osprey-dcs/rf-input-fmc/datasheet.md

- 2 Independent RF inputs
- 15 Digital inputs
- 1 PPS input

## Clock Inputs

| **parameter** | value |
| --- | --- |
| connector type | SMA-F |
| Targeted Input Bandwidth | 50MHz- 200Mhz |
| Absolute Input Bandwidth | 50MHz- 3000Mhz |
| Input Range | -5 to +20 dBm |
| Absolute Input Range | -5.8dbm - 25.9 dBm |
| Clock Divider | 1x - (1/8)x |
| Input Impedance | 50 ohm +/- 0.5% |

### Input Bandwidth
We are targeting a 50-200MHz input, while the input parts are rated for higher then 200Mhz operation, we will be likely limited by non-ideal effects of the realized circuit.
LMK and front end can handle

| **Part** | **Frequency(MHz)** |
| --- | --- |
| TCP-2-33W+ | 50 - 3000 |
| TCM2-33WX+ | 10 - 3000 |
| LMK01801 | ?- 3100 |
The FPGA Clock input only operate up to 650MHz.
<span style="color: red;">Dividers bringing the final input frequency down to below 650MHz must be used.</span>
Realistically, that layout will limit the bandwidth *we should test this limit*

### Input Range

From LMK01801 [datasheet](https://www.ti.com/lit/ds/symlink/lmk01801.pdf) section 7.4:
Vin_max = 3.1V p-p
Vin_min = 0.5V p-p

Adding in the losses from input transformers we arrive at an input range of:
2.26dBm though 18.11 dBm.

An absolute max input can 19.41 dBm.
## Digital Inputs

| **parameter** | value |
| --- | --- |
| connector type | Samtec Isorate *Part Number* |
| input impedance | 50 ohm(PPS Input) or high impedance |
| V<sub>IH</sub> | > 1.70 V |
| V<sub>IL</sub> | < 0.70 V |
| Intended Input Logic Levels | 5.0V, 3.3V, 2.5V |
| Absolute Maximum Input | 6.5V |
| Maximum Switching Speed | <span style="color: red;">????</span> |

## FMC PINOUT
<span style="color: red;">Add pinout here</span>
** What cannot be tri-stated with other firmware
- sample clk output - Quartz?
-
## Connector
The mating connector is as thin as the right angle part so the right angle connector can sit back on the board.
![[Pasted image 20251030092402.png]]

We will need 28 mm of clarence min above the board for the connector
![[Pasted image 20251030104230.png]]
