osprey-dcs/rf-input-fmc/(commit log)

2025-09-30 Initial Commit
    Basic Schematic Started.
    Needs polish but components are in.
    [digital_inputs.kicad_sch, fmc.kicad_sch, housekeeping.kicad_sch, rf-input-fmc.kicad_pcb, rf-input-fmc.kicad_sch, rf_input.kicad_sch]
2025-10-01 Draft Schematic Complete
    -See design.md for remaining design work/questions
    -See output folder for current schematic prints
    [adc.kicad_sch, digital_inputs.kicad_sch, eeprom.kicad_sch, fmc.kicad_sch, housekeeping.kicad_sch, level_shifter.kicad_sch, rf-input-fmc.kicad_sch, rf_input.kicad_sch]
2025-10-04 lmk01801 symbol pin types and datasheet link
    [rf_input.kicad_sch]
2025-10-04 add power flags
    [fmc.kicad_sch]
2025-10-04 fixup some hierarchical buses
    [digital_inputs.kicad_sch, fmc.kicad_sch, level_shifter.kicad_sch, rf-input-fmc.kicad_sch, rf_input.kicad_sch]
2025-10-04 show inter-sheet references for global labels
    [level_shifter.kicad_sch]
2025-10-06 Schamtic Revision
    - Added 8 more D inputs
    - Removed 1 LMK01801 IC
    - Cleaned up some buses
    [adc.kicad_sch, clk_distribution.kicad_sch, digital_inputs.kicad_sch, eeprom.kicad_sch, fmc.kicad_sch, level_shifter.kicad_sch, rf-input-fmc.kicad_sch, rf_input.kicad_sch]
2025-10-07 Draft Schematic Revision
    Schematic should be in good shape.
    Meta-data and BOM need to be finished.
    Very rough layout was started to floorplan out main parts and to see if we have room.
    [adc.kicad_sch, clk_distribution.kicad_sch, digital_inputs.kicad_sch, eeprom.kicad_sch, fmc.kicad_sch, level_shifter.kicad_sch, rf-input-fmc.kicad_pcb, rf-input-fmc.kicad_sch]
2025-10-14 add copyright/license
    [adc.kicad_sch, clk_distribution.kicad_sch, digital_inputs.kicad_sch, eeprom.kicad_sch, fmc.kicad_sch, level_shifter.kicad_sch, rf-input-fmc.kicad_pcb, rf-input-fmc.kicad_sch]
2025-10-16 Changed ADC and removed Level Shifter
    - Changed ADC to ADS7253
    - Removed Level Shifters
    - Change paper size to US standard sizes for printing
    - removed 3d models
    - Changed SMA clock input to a 2 pin ISORATE connector
    - Floor planned out the PCB layout with the new parts
    [adc.kicad_sch, clk_distribution.kicad_sch, digital_inputs.kicad_sch, eeprom.kicad_sch, fmc.kicad_sch, level_shifter.kicad_sch, rf-input-fmc.kicad_pcb, rf-input-fmc.kicad_sch]
2025-10-28 Final Schmatic Draft
    -Changed ADC
    -Changed Digital IO Translator
    -Updated all MPNs
    - Reannoted Schematic
    - Updated Design Document
    - Added new Datasheet Document
    [adc.kicad_sch, digital_inputs.kicad_sch, eeprom.kicad_sch, fmc.kicad_sch, rf-input-fmc.kicad_pcb, rf-input-fmc.kicad_sch, rf_input.kicad_sch]
2025-10-30 Updated Footprint of Connectors
    -Added a 0 ohm resistor after the 5V LDO
    - fixed some part numbers
    - adding 3d model to the isorate connectors
    - updated datasheet/design docs
    - changed one of the DIO connector to a vertical connector
    [adc.kicad_sch, digital_inputs.kicad_sch, fmc.kicad_sch, rf-input-fmc.kicad_pcb]
2025-11-04 Schematic updates
    - Changed Connecters to MMCX
    - Added Test points on clocks and data buses
    - Added attenuation before the RF input level detection IC to better keep the recommended input within its linear range
    - Added a low pass filter at the input of the RF input level detection IC
    - grounded the thermal pad of the ADC
    - added some additional decoupling caps in for the clock splitter chip (to be in line with what is on Zest)
    [adc.kicad_sch, clk_distribution.kicad_sch, digital_inputs.kicad_sch, eeprom.kicad_sch, rf-input-fmc.kicad_pcb, rf-input-fmc.kicad_sch, rf_input.kicad_sch]
2025-11-04 Fixed Physical Board Demensions
    - mirrored and resized the board outlined to match the FMC standard
    - added two non-electrical mounting holes (created a footprint for these)
    - moved and locked the FMC connector and mounting holes to FMC standard locations.
    - moved connector to fit the new board size
    [fmc.kicad_sch, rf-input-fmc.kicad_pcb]
2025-11-11 Updated BOM of all parts
    Updated BOM of all parts
    -added supplier & supplier part number to all parts
    - fixed many issues with part including:R5-R8,C34,C35,C24, R10-R15
    Changed filter C36&C37 to 15nF (keep COG & 0603, but changes filter cutoff to 3.8kHz|was 12kHz)
    Changed bulk Caps to 22uF (was 47uF) to get a Cap with enough voltage headroom at 12V while 0805
    Changed C31 to be a bulk 10uF cap
    [adc.kicad_sch, clk_distribution.kicad_sch, digital_inputs.kicad_sch, eeprom.kicad_sch, fmc.kicad_sch, rf-input-fmc.kicad_pcb, rf-input-fmc.kicad_sch, rf_input.kicad_sch]
2025-12-02 Finished Board Layout
    Schematic Changes
    - Removed some testpoints
    - Fixed Lib issues
    - moved around FMC pinout
    Layout
    - routed all traces
    - routed RF traces using Controlled Impedance in mind
    - ERC/DRC free
    - All silkscreen is arranged
    Still to do
    - finish net-classes for controlled traces
    - create arc traces for diff CLK lines
    - small tweaks to improve RF performance
    [adc.kicad_sch, digital_inputs.kicad_sch, fmc.kicad_sch, rf-input-fmc.kicad_pcb, rf-input-fmc.kicad_sch, rf_input.kicad_sch]
2025-12-02 Tweaks to Layout/ fixed project errors
    -Adjusted Testpoints by changing the value field to visible on the silkscreen layer.
    - Fixed DRC and ERC issues
    Known to do:
    - run rounded traces
    - determine neg/gnd pin of J20 (do we want to float but diff? SE?)
    - determine/implement best practice grounding for mounting holes?
    - Additional RF trace tweaking
    [adc.kicad_sch, clk_distribution.kicad_sch, digital_inputs.kicad_sch, fmc.kicad_sch, rf-input-fmc.kicad_pcb]
2025-12-05 updated layout to improve RF
    - Improved RF traces
    -Changed some 0603 passives to 0402 parts
    - Changed J1 &J2 to SMA connectors
    [clk_distribution.kicad_sch, rf-input-fmc.csv, rf-input-fmc.kicad_pcb, rf_input.kicad_sch]
2025-12-20 Final Draft for prototype run
    - Updated CLK mapping to FMC
    - Now Output 12 goes to M2C CLK instead of a GBT CLK
    - Outputs 0, 4, 8 have moved
    - all CLK now have polarity swapped at the FMC pin
    - CLK signals maintain normal polarity through the CLK distribution chip but are now ALL swapped between the CLK Distribution IC output and the FMC pins
    - Added a monitor output on Output13 (J20)
    - Moved decoupling caps to bottom of LCB in many places
    - Standardized the area to the right of the FMC to use as a future template
    - Moved board specific test points and function to the left
    - Added an additional bypass cap on U8
    - Tied the front two mounting hole (H3 &H4) to GND
    - changed H2 to be a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
    [clk_distribution.kicad_sch, digital_inputs.kicad_sch, eeprom.kicad_sch, fmc.kicad_sch, rf-input-fmc.kicad_pcb, rf-input-fmc.kicad_sch]
2025-12-21 add datasheet links
    [eeprom.kicad_sch, rf_input.kicad_sch]
2025-12-21 remove unused layers
    [rf-input-fmc.kicad_pcb]
2025-12-21 remove references to unused ISORATE connectors
2025-12-21 quiet some kibot complaints
    space at end of property value
    [adc.kicad_sch, clk_distribution.kicad_sch, eeprom.kicad_sch, rf-input-fmc.kicad_pcb, rf_input.kicad_sch]
2025-12-22 Updated Final Draft for prototype run
    - Add missing MPN's to some passives
    - Double Checked all BoM
    - Add silkscreen labels to LEDs
    - Added keystone testpoints for power and ground connections
    - Adjusted Bypass cap placement
    - C31,C32,C39, C33
    - Moved VDD3P3 LED and CLR
    - Moved bulk bypass caps C34, C35 closer to power input vias
    - Shorted GBT_CLK line between LMK output 4 and FMC
    - Moved Power input via for U7
    [clk_distribution.kicad_sch, fmc.kicad_sch, rf-input-fmc.kicad_pcb, rf_input.kicad_sch]
2025-12-23 Updated Supplier part numbers
    Updated Supplier part number for parts with incorrect or missing info
    [adc.kicad_sch, clk_distribution.kicad_sch, eeprom.kicad_sch, fmc.kicad_sch, rf_input.kicad_sch]
2025-12-23 Prototype Production Ready
    - Removed Supplier and Supplier Part Numbers for project
    - Changed Kibot to not out Supplier and Supplier Part Numbers for project
    - Changed a few ignored ERC/DRC testing to warnings, and found no additional issues
    - project is ready for production
    [adc.kicad_sch, clk_distribution.kicad_sch, digital_inputs.kicad_sch, eeprom.kicad_sch, fmc.kicad_sch, rf-input-fmc.kicad_pcb, rf-input-fmc.kicad_sch, rf_input.kicad_sch]
2025-12-23 fix LMK part number
    [clk_distribution.kicad_sch, rf-input-fmc.kicad_pcb]
2025-12-23 remove static BoM
    [rf-input-fmc.csv]
2026-05-13 kibot fix BoM
2026-05-14 Changes to Based on Pre-Production Run
    - Added FPGA control for digital input buffer's OE pin with pull up
    - Grounded ref caps on ADC properly
    - Swapped pins 5&6 on U7 (polarity fix)
    - Fixed naming of CLK inputs to be "CLK1" / "CLK2" to be clk0 & clk1 inputs on LMK
    - Changed "J" tag to be digital IO only "J1 - J16"
    - Mounting Holes changed 3.0mm to match with Marble
    - Added 50ohm non-populated resistors in on digital inputs
    - Changed labeling of ADC inputs in schematic (no copper changes)
    - Changed labeling/assignment of digital inputs on the FMC connector (almost no copper changes)
    - now J1 = Dinput1 ... J15= Dinput16; J16 = PPS (PPS has unchanged mapping)
    - Swapped h37 and g37 pin a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
    [adc.kicad_sch, clk_distribution.kicad_sch, digital_inputs.kicad_sch, fmc.kicad_sch, rf-input-fmc.kicad_pcb, rf-input-fmc.kicad_sch]
2026-05-14 Updates based on Review
    -Added Missing "PG_C2M" label
    -Added heartbeat signal to fmc (was missing on previous commit)
    -Changed all vias to 0.6mm with 0.3mm hole
    -Adjusted one via near pin7 of U7 to accommodate this change
    -Changed traces around U4 to R25 to keep trace straight
    -Added GND via at pin5 of U7 & connected all GND pins of U7 to PAD
    -Moved R9 near J16 connector
    -Changed name of board on silkscreen to "Clock Input FMC" project/file name changes will come in later commits.
    -Standardized "J*" labels to all be consistent
    -Swapped FMC pins for Din14 & Din15. This undoes some complications in the last commit with pin swaps
    -Removed net references to "P1_" in net names
    -Adjusted plane la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
    [adc.kicad_sch, digital_inputs.kicad_sch, eeprom.kicad_sch, fmc.kicad_sch, rf-input-fmc.kicad_pcb]
2026-05-19 Updates before production run
    - Changed mechanical mounting holes to slots for universal marble & FMC spec compatibility
    - Moved Present trace coming from FMC pin H2 away from hole
    - Moved Via near C29 a little away from the cap
    - Moved optional 50 ohm terminations to be aligned between the connector row
    - Shortened Traces leading to ADC inputs
    - Changed thermal vias in ADC & CLK IC from 0.2mm -> 0.3mm holes
    - Removed thermal relief spokes on ground layer connections of the thermal vias under IC's
    - Enlarged Plane layer on "in2" layer for 'LMK_VCC_13" net for better connections
    [clk_distribution.kicad_sch, digital_inputs.kicad_sch, fmc.kicad_sch, rf-input-fmc.kicad_pcb]
2026-05-20 PCB trace tweaks
    - Fixed trace by pin12 of U5
    - Fixed traces around R26
    - Centered no-pop termination resistors between MMCX rows
    [rf-input-fmc.kicad_pcb]
2026-05-20 Changing Files names
    Changes file naming from rf-input-fmc to clk-input-fmc
    [clk-input-fmc.kicad_pcb, clk-input-fmc.kicad_sch]
2026-05-20 Changed Title Blocks to Version 1.0
    - changed title blocks
    - changed silkscreen to add version number
    [adc.kicad_sch, clk-input-fmc.kicad_pcb, clk-input-fmc.kicad_sch, clk_distribution.kicad_sch, digital_inputs.kicad_sch, eeprom.kicad_sch, fmc.kicad_sch, rf_input.kicad_sch]
2026-05-20 Rounded Corners of high-speed diff traces
    - Rounded corners using a 0.6mm radius
    - updated footprint to avoid DRC warning (no copper changes)
    - Only change was to the silkscreen of a pin 1 indicator on the sot-23 package we use
    - The silkscreen ref des was moved slightly for Q3 with the above change
    [clk-input-fmc.kicad_pcb]
