osprey-dcs/rf-input-fmc/(notices)

Notices in the files:
clk-input-fmc.kicad_pcb:
SPDX-FileCopyrightText: 2025 Osprey DCS
SPDX-License-Identifier: CERN-OHL-S-2.0+
